dfacchin/Car_DIY/hardware/chassis_preview.png

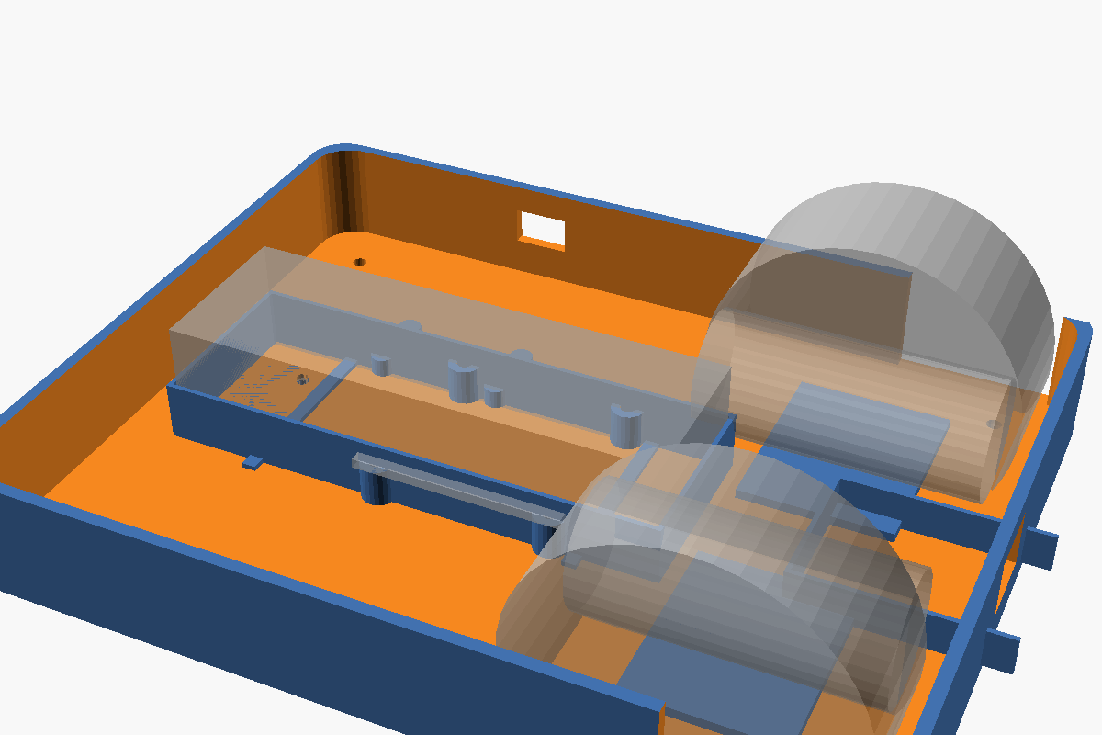
hardware/chassis_preview.png
