dfacchin/Car_DIY/hardware/chassis_top.png

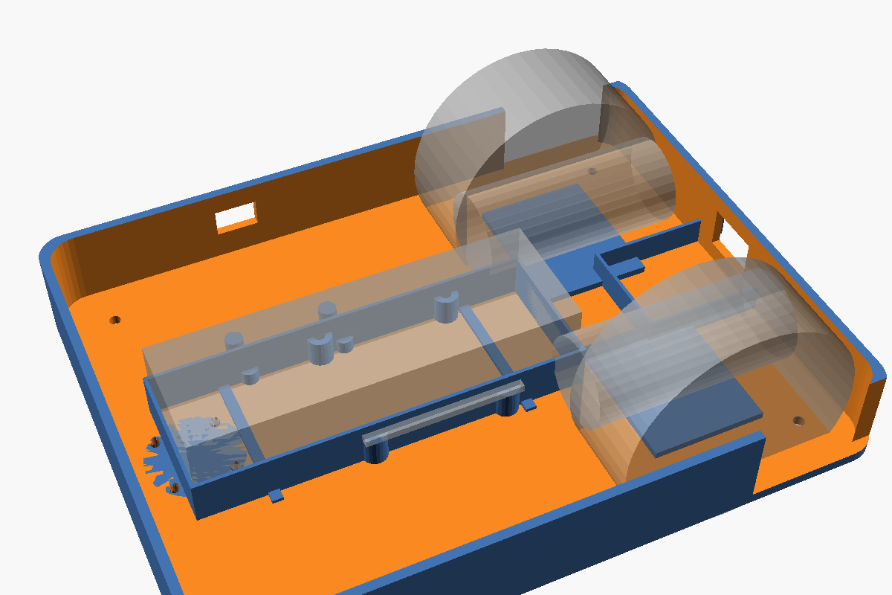
hardware/chassis_top.png
