dfacchin/Car_DIY/hardware/chassis.stl

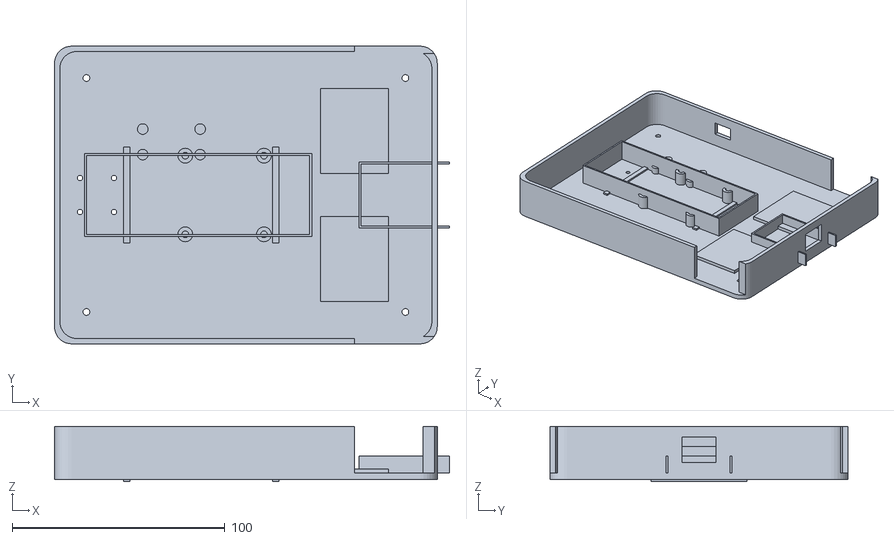
[picture p3: CAD file, 2026-03-27]
hardware/chassis.stl
185.8 x 140.0 x 26.0
