dfacchin/Car_DIY/(commit log)

2026-03-27 Initial project setup: RC car with ESP32-CAM, motor controller, and Flutter app
    Complete project structure with three software components:
    - firmware_esp32cam: WiFi AP, MJPEG video streaming, web UI with joystick/tank controls
    - firmware_motor: PID motor control for JGA25-370 motors, encoder reading, safety features
    - app_controller: Flutter smartphone app with joystick, tilt, and tank control modes
    Plus shared UART protocol definition and hardware documentation (wiring, power budget, BOM).
2026-03-27 Fix build errors: prefix protocol error codes, add Flutter platform scaffolding
    - Prefix ERR_* macros to PROTO_ERR_* to avoid conflict with ESP-IDF lwip
    - Remove unused async web server lib deps from ESP32-CAM
    - Replace broken flutter_mjpeg with custom MJPEG stream parser
    - Add Flutter platform folders (android/ios/web/etc) for buildable app
    [main.cpp, protocol.h, safety.cpp]
2026-03-27 Add OTA firmware update for ESP32-CAM and Arduino Pro Mini flashing via web UI
    - ESP32 OTA: upload .bin firmware via web interface, auto-reboot after flash
    - Arduino flash: upload .hex file via web, ESP32 speaks STK500v1 bootloader
    protocol over UART to reprogram Arduino Pro Mini without physical access
    - New wiring: ESP32 GPIO 2 -> Arduino RESET pin (for bootloader entry)
    - Web UI: new "Firmware" tab with upload forms and progress indicators
    [avr_flash.cpp, avr_flash.h, config.h, main.cpp, ota.cpp, web_server.cpp]
2026-03-27 Add PID tuning, admin debug page, brake, drive UI, captive portal, and doc sync
    Protocol: add CMD_BRAKE, CMD_GET/SET/SAVE_PID, CMD_GET_DEBUG, RSP_PID_PARAM,
    RSP_DEBUG, RSP_ENCODERS. PID params stored in EEPROM on motor controller.
    Motor firmware: active brake (H-bridge short, wheels locked), PID param
    load/save from EEPROM, debug mode with PWM/target/encoder telemetry,
    cumulative encoder counters, ramp limiting from stored params.
    ESP32-CAM: motor UART moved to Serial2 (GPIO 14/15), freeing UART0 for USB
    debug. Camera stream runs in FreeRTOS task on core 0 (non-blocking). Open
    WiFi AP with unique SSID from MAC (Car_XXXX). Captive portal with DNS server.
    Web UI: Drive mode (throttle + brake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
    [camera.cpp, comm.cpp, comm.h, config.h, encoder.cpp, encoder.h]
2026-03-27 Fix ESP32-CAM pin assignments for reliable USB flashing, add TX/RX counters
    Pin assignment finalized — no wires need disconnecting for USB flashing:
    - GPIO 12: Motor UART TX (strapping pin, safe as ESP32 output)
    - GPIO 14: Motor UART RX (not strapping)
    - GPIO 13: AVR RESET (not strapping, INPUT mode with Arduino pull-up)
    - GPIO 4: Flash LED (preserved)
    AVR flash: fix STK500v1 to use Serial2 instead of Serial (was sending
    bootloader commands to USB debug port). RESET pin uses INPUT/OUTPUT
    toggle to avoid driving GPIO high permanently.
    Admin page: add TX/RX packet counters for UART debug.
    Add 3D printable chassis (OpenSCAD parametric + STL), test firmware for
    Arduino Pro Mini (1Hz and 5Hz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
    [chassis.scad, chassis.stl]
2026-03-28 Rewrite UART protocol V2: strict request/response, auto-flash, version tracking
    Protocol V2 (shared/protocol.h):
    - 9-byte request, 15-byte response, exactly 1 response per request
    - Commands: R(RPM), P(PWM), S(stop), B(brake), V(version), G/T/W(PID),
    N(pins), D(debug), F(safety) — all uppercase request, lowercase response
    - Response always includes: echo payload + actual RPM + Arduino rx_count
    - Baud rate: 38400 (0% error on 8MHz Pro Mini, was 115200 with -3.5% error)
    ESP32-CAM:
    - Pin change: UART RX moved from GPIO 14 to GPIO 15 (both non-strapping)
    - Auto-flash: boot verify reads Arduino flash via STK500v1 READ_PAGE,
    compares byte-by-byte against LittleFS hex, flashes only if differ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
    [avr_flash.cpp, avr_flash.h, comm.cpp, comm.h, config.h, increment_version.py, main.cpp]
2026-03-28 Fix motor swap and encoder direction to match physical wiring
    Motor mapping in config.h (no wiring changes needed):
    - MOTOR_SWAP=1: left command -> Motor B, right command -> Motor A
    - MOTOR_LEFT_INVERT=1, MOTOR_RIGHT_INVERT=-1: direction correction
    - ENC_LEFT_INVERT=-1, ENC_RIGHT_INVERT=-1: both encoders inverted
    PID loop uses mapped encoder readings and motor outputs.
    Protocol responses report logical (corrected) RPM values.
    [config.h, main.cpp]
